dennissammy77/ROV_FINAL_YEAR_PROJECT/ELECTRONICS/MPU6050-1.3.1/README.md

# MPU6050 by Electronic Cats - Library for Arduino

<a href="https://github.com/ElectronicCats/mpu6050/wiki">
  
</a>

<p>
<a href="https://github.com/ElectronicCats/mpu6050/wiki">
  
</a>
</p>



Arduino library for controlling MPU6050 module.

MPU6050 Combines a 3-axis gyroscope and a 3-axis accelerometer on the same silicon die together with
an onboard Digital Motion Processor(DMP) which processes complex 6-axis MotionFusion algorithms.

## Features of this version

- ### Supported Chipsets
  - AVR
  - SAM
  - SAMD21 
  - ARM
  - ESP32 
  - ESP8266
  - RENESAS

#### Original Library

Based in the work of [jrowberg/i2cdevlib](https://github.com/jrowberg/i2cdevlib/tree/master/Arduino/MPU6050)

## Quick Installing

To install, use the [Arduino Library Manager](https://support.arduino.cc/hc/en-us/articles/5145457742236-Add-libraries-to-Arduino-IDE) and search for "MPU6050" and install the MPU6050 by Electronic Cats library.

## Maintainer

<a href="https://github.com/sponsors/ElectronicCats">
 <p align="center">
  
 </p>
</a>

Electronic Cats invests time and resources providing this open source design, please support Electronic Cats and open-source hardware by purchasing products from Electronic Cats!
