dennissammy77/ROV_FINAL_YEAR_PROJECT/ELECTRONICS/Untitled.png

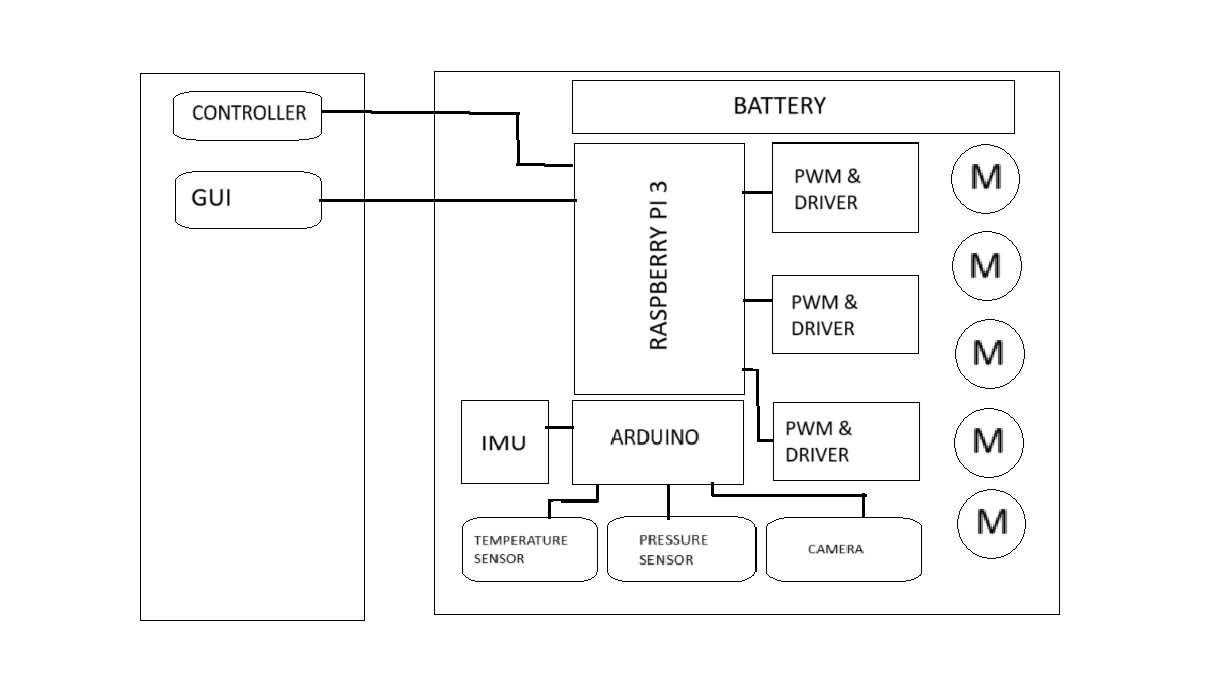
ELECTRONICS/Untitled.png
