dennissammy77/ROV_FINAL_YEAR_PROJECT/ELECTRONICS/vendar.png

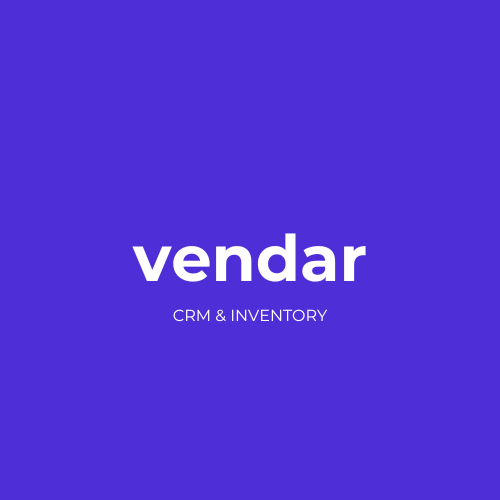
ELECTRONICS/vendar.png
