dennissammy77/ROV_FINAL_YEAR_PROJECT/Screenshot 2024-07-05 031217.png

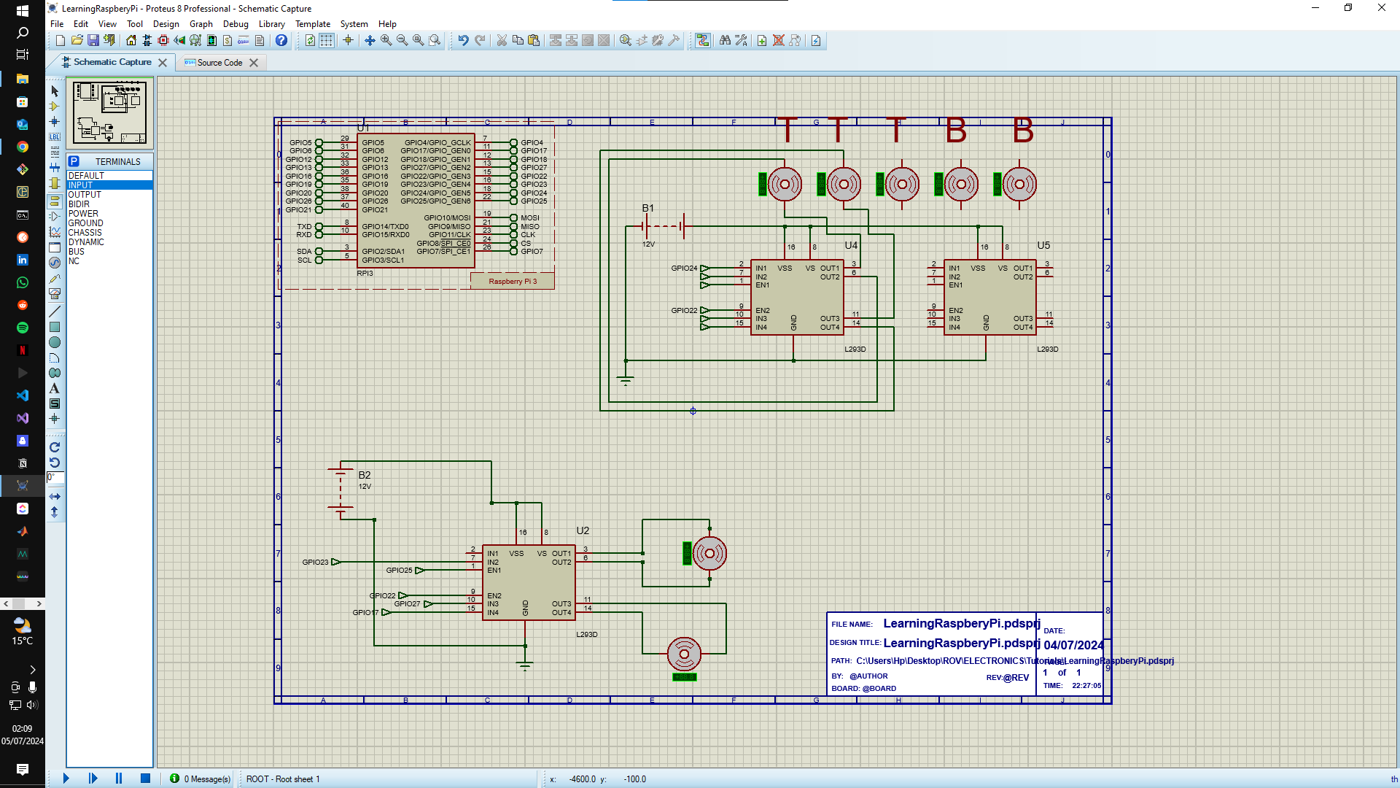
Screenshot 2024-07-05 031217.png
