dennissammy77/ROV_FINAL_YEAR_PROJECT/ELECTRONICS/MPU-6050.step

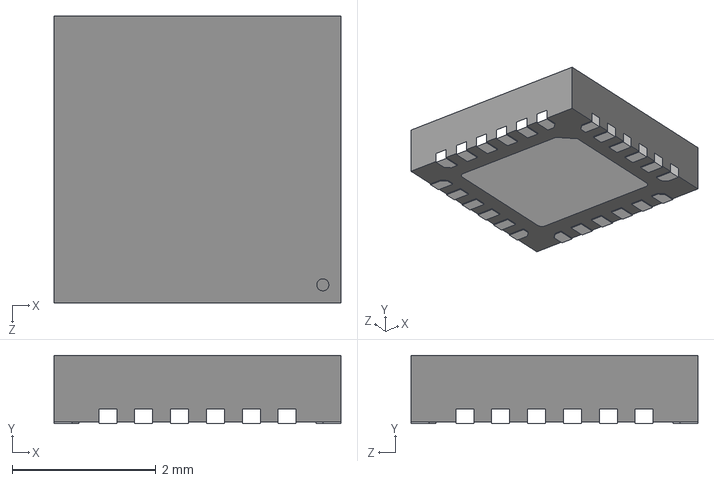
[picture p55: CAD file, 2024-07-18]
ELECTRONICS/MPU-6050.step
4.00 x 0.95 x 4.00 mm
