dennissammy77/ROV_FINAL_YEAR_PROJECT/ELECTRONICS/MPU6050-1.3.1/examples/MPU6050_DMP6_using_DMP_V6v12/MPUplane/data/biplane.obj

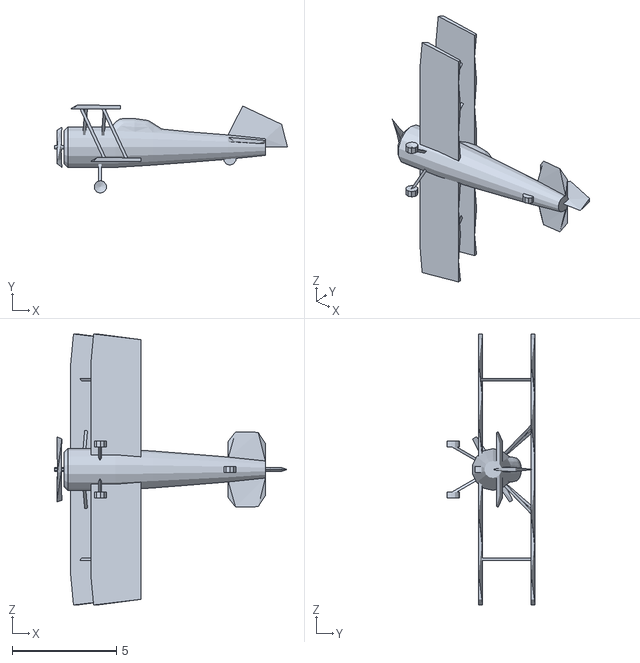
[picture p56: CAD file, 2024-07-18]
ELECTRONICS/MPU6050-1.3.1/examples/MPU6050_DMP6_using_DMP_V6v12/MPUplane/data/biplane.obj
11.2 x 4.23 x 13.0
