dennissammy77/ROV_FINAL_YEAR_PROJECT/(list of files, cad)

Other CAD files:
ROV frame sketch v1.f3d
