dennissammy77/ROV_FINAL_YEAR_PROJECT/ELECTRONICS/ROV_Circuit_Diagram.pdf

## ROV Circuit Diagram

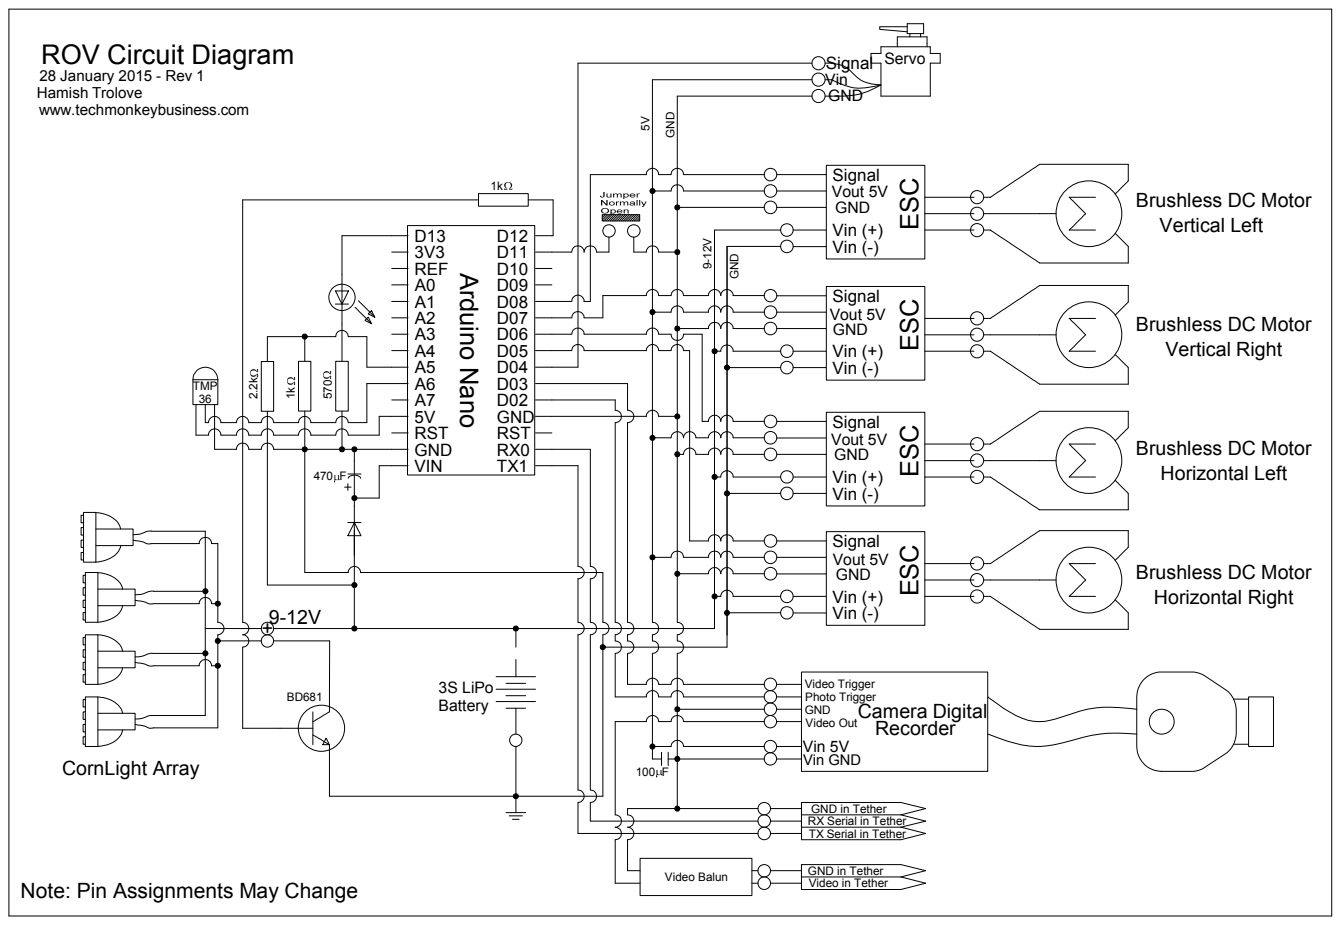
[picture p57: page 1]

GND in Tether
RX Serial in Tether
TX Serial in Tether

Note: Pin Assignments May Change
