dennissammy77/ROV_FINAL_YEAR_PROJECT/ELECTRONICS/ROV_SCHEMATIC.PDF

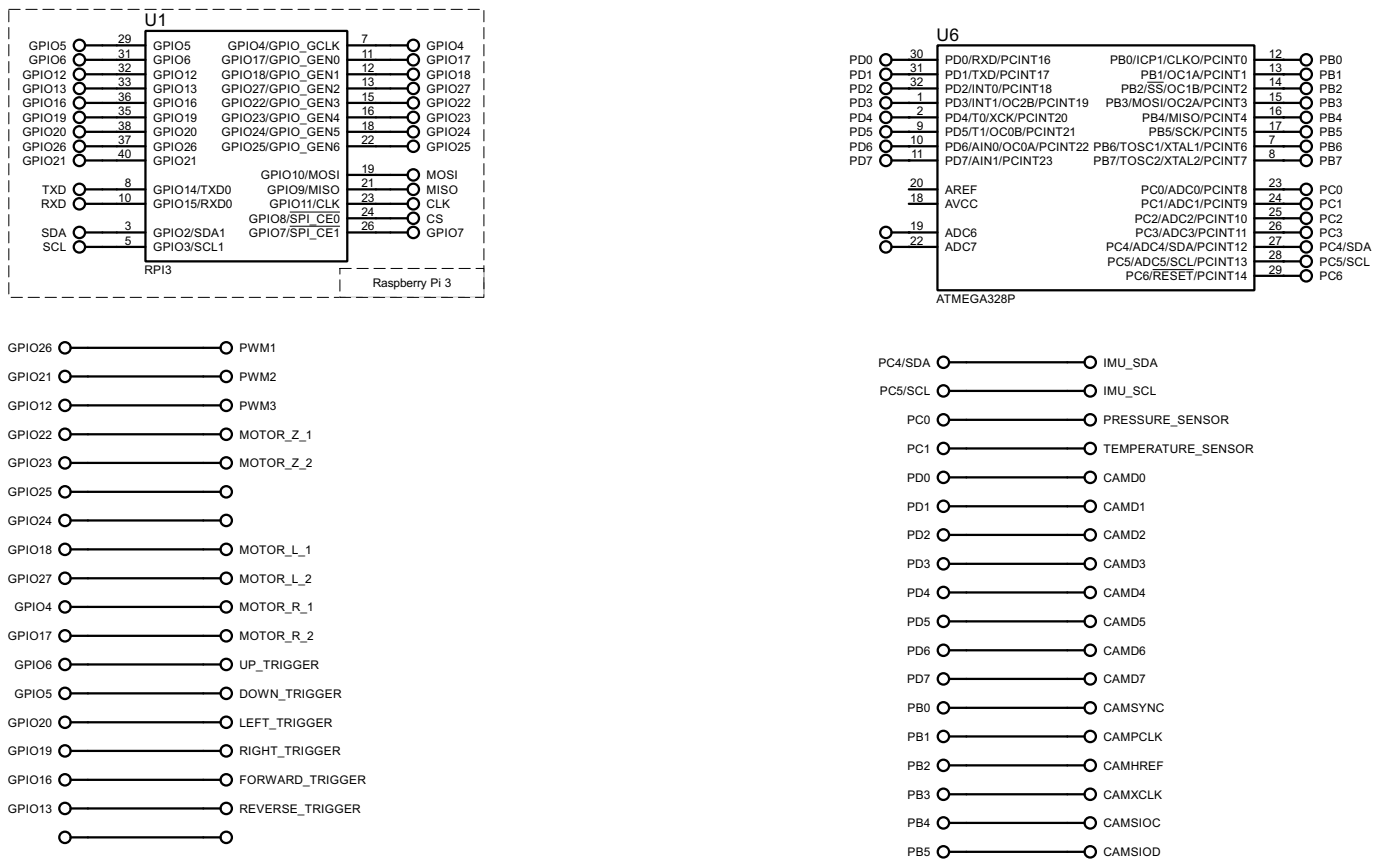
[picture p58: page 1]

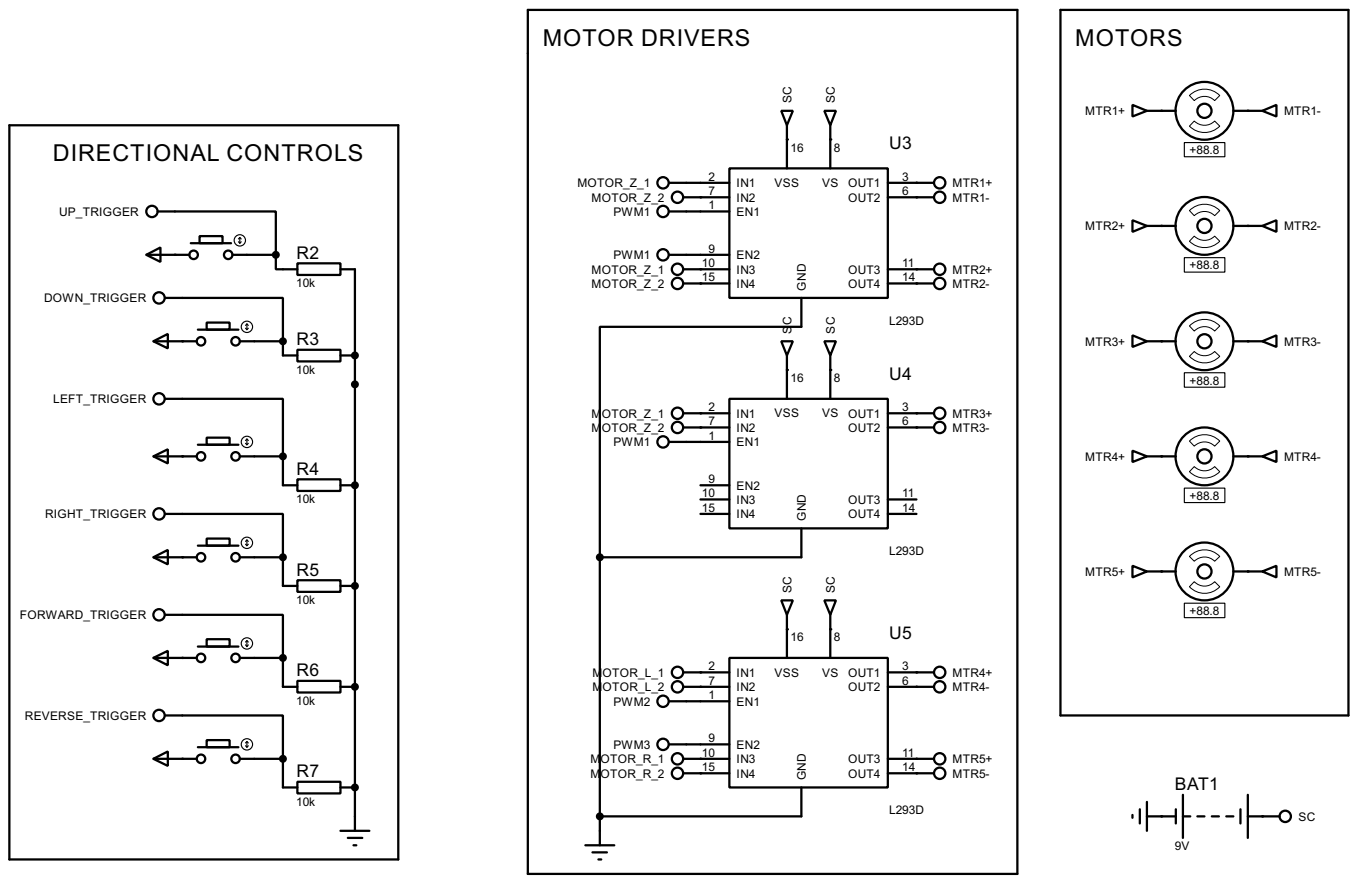
[picture p59: page 2]

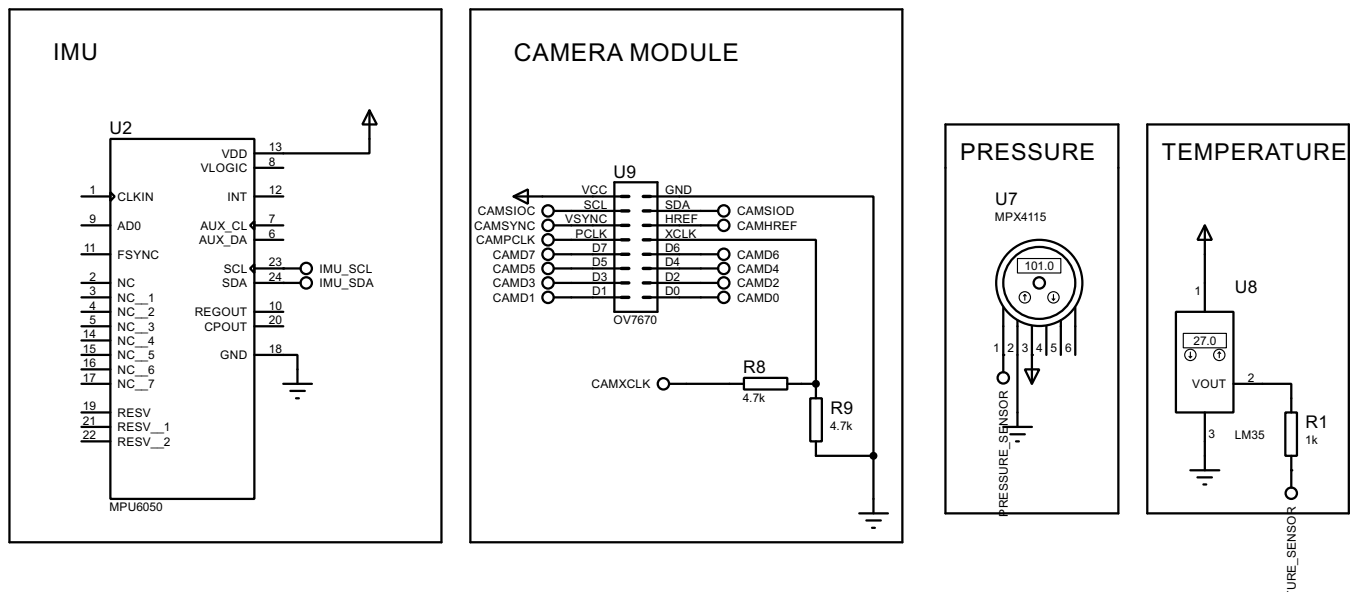
[picture p60: page 3]
