dennissammy77/ROV_FINAL_YEAR_PROJECT/(list of files, drawings)

Other design files:
ELECTRONICS/Project Backups/ROV_SCHEMATIC [20240716, 13-58-19].pdsprj
ELECTRONICS/Project Backups/ROV_SCHEMATIC [20240717, 15-17-19].pdsprj
ELECTRONICS/Project Backups/ROV_SCHEMATIC [20240717, 15-17-20].pdsprj
ELECTRONICS/Project Backups/ROV_SCHEMATIC [20240719, 07-34-27].pdsprj
ELECTRONICS/Project Backups/ROV_SCHEMATIC [20240719, 08-50-16].pdsprj
ELECTRONICS/Project Backups/ROV_SCHEMATIC [20240719, 22-49-17].pdsprj
ELECTRONICS/Project Backups/ROV_SCHEMATIC [20240724, 14-47-46].pdsprj
ELECTRONICS/Project Backups/ROVSCHEMATICt [20240704, 22-19-43].pdsprj
ELECTRONICS/Project Backups/ROVSCHEMATICt [20240704, 22-19-46].pdsprj
ELECTRONICS/Project Backups/ROVSCHEMATICt [20240704, 22-20-18].pdsprj
ELECTRONICS/Project Backups/ROVSCHEMATICt [20240704, 22-21-20].pdsprj
ELECTRONICS/ROV_SCHEMATIC.pdsprj
ELECTRONICS/ROVSCHEMATICt.pdsprj
ELECTRONICS/Tutorials/LearningRaspberyPi.pdsprj
ELECTRONICS/Tutorials/Project Backups/LearningRaspberyPi [20240714, 14-01-35].pdsprj
ELECTRONICS/Tutorials/Project Backups/LearningRaspberyPi [20240714, 20-06-43].pdsprj
ELECTRONICS/Tutorials/Project Backups/LearningRaspberyPi [20240715, 15-07-44].pdsprj
ELECTRONICS/Tutorials/Project Backups/LearningRaspberyPi [20240715, 15-13-30].pdsprj
ELECTRONICS/Tutorials/Project Backups/LearningRaspberyPi [20240715, 15-19-27].pdsprj
ELECTRONICS/Tutorials/Project Backups/LearningRaspberyPi [20240716, 09-01-54].pdsprj
ELECTRONICS/Tutorials/Project Backups/LearningRaspberyPi [20240718, 08-40-00].pdsprj
ELECTRONICS/Tutorials/Project Backups/LearningRaspberyPi [20240726, 10-31-34].pdsprj
