dennissammy77/ROV_FINAL_YEAR_PROJECT/(commit log)

2024-07-09 Working on Making motors on independent axis work separately
2024-07-11 some new changes
    [LearningRaspberyPi [20240710, 01-20-30].pdsprj, LearningRaspberyPi.pdsprj]
2024-07-18 New schematics for rov
    [LearningRaspberyPi [20240705, 03-13-51].pdsprj, LearningRaspberyPi [20240708, 13-49-41].pdsprj, LearningRaspberyPi [20240714, 20-06-43].pdsprj, LearningRaspberyPi [20240715, 15-07-44].pdsprj, LearningRaspberyPi [20240715, 15-13-30].pdsprj, LearningRaspberyPi [20240715, 15-19-27].pdsprj, LearningRaspberyPi [20240716, 09-01-54].pdsprj, LearningRaspberyPi.pdsprj]
2024-07-19 New update
    [LearningRaspberyPi [20240708, 13-49-43].pdsprj, LearningRaspberyPi [20240718, 08-40-00].pdsprj, LearningRaspberyPi.pdsprj, ROV_SCHEMATIC [20240719, 07-34-27].pdsprj, ROV_SCHEMATIC [20240719, 08-50-16].pdsprj, ROV_SCHEMATIC.pdsprj]
2024-08-01 GUI development
    [LearningRaspberyPi [20240710, 01-20-30].pdsprj, LearningRaspberyPi [20240726, 10-31-34].pdsprj, LearningRaspberyPi.pdsprj, ROV_SCHEMATIC [20240719, 22-49-17].pdsprj, ROV_SCHEMATIC [20240724, 14-47-46].pdsprj, ROV_SCHEMATIC.pdsprj]
